juntaow0/Arduino8KeyPiano/README.md

## Arduino Eight Key Piano  
- Constructed an 8-key piano using an Arduino with a partner
- Utilized shift registers for enabling 8 buttons and 8 LEDs with only 6 pins
