juntaow0/Arduino8KeyPiano/acat.h

int Sa [] = {
		NOTE_C4,NOTE_C4,NOTE_C4,NOTE_C4,NOTE_DS4,NOTE_DS4,NOTE_DS4,NOTE_DS4,
		NOTE_F4,NOTE_F4,NOTE_F4,NOTE_DS4,NOTE_DS4,NOTE_DS4,NOTE_F4,NOTE_F4,
		NOTE_F4,NOTE_F4,NOTE_F4,NOTE_F4,NOTE_AS4,NOTE_AS4,NOTE_GS4,NOTE_GS4,
		NOTE_G4,NOTE_F4,NOTE_F4,NOTE_G4,NOTE_G4,NOTE_G4,0,0,NOTE_G4,NOTE_G4,
		NOTE_G4,NOTE_G4,NOTE_AS4,NOTE_AS4,NOTE_AS4,NOTE_AS4,NOTE_C5,NOTE_C5,
		NOTE_C5,NOTE_F4,NOTE_F4,NOTE_F4,NOTE_DS4,NOTE_DS4,NOTE_AS4,NOTE_AS4,
		NOTE_AS4,NOTE_AS4,NOTE_G4,NOTE_G4,NOTE_AS4,NOTE_AS4,NOTE_AS4,NOTE_AS4,
		NOTE_AS4,NOTE_C5,NOTE_C5,NOTE_F4,NOTE_G4,NOTE_AS4,
		NOTE_C4,NOTE_C4,NOTE_C4,NOTE_C4,NOTE_DS4,NOTE_DS4,NOTE_DS4,NOTE_DS4,
		NOTE_F4,NOTE_F4,NOTE_F4,NOTE_DS4,NOTE_DS4,NOTE_DS4,NOTE_F4,NOTE_F4,
		NOTE_F4,NOTE_F4,NOTE_F4,NOTE_F4,NOTE_AS4,NOTE_AS4,NOTE_GS4,NOTE_GS4,
		NOTE_G4,NOTE_F4,NOTE_F4,NOTE_G4,NOTE_G4,NOTE_G4,0,0,NOTE_G4,NOTE_G4,
		NOTE_G4,NOTE_G4,NOTE_AS4,NOTE_AS4,NOTE_AS4,NOTE_AS4,NOTE_C5,NOTE_C5,
		NOTE_C5,NOTE_F4,NOTE_F4,NOTE_F4,NOTE_DS4,NOTE_DS4,NOTE_AS4,NOTE_AS4,
		NOTE_AS4,NOTE_AS4,NOTE_G4,NOTE_G4,NOTE_AS4,NOTE_AS4,NOTE_AS4,NOTE_AS4,
		NOTE_AS4,NOTE_C5,NOTE_C5,0,0,0,
		NOTE_C4,NOTE_C4,NOTE_C4,NOTE_C4,NOTE_DS4,NOTE_DS4,NOTE_DS4,NOTE_DS4,
		NOTE_F4,NOTE_F4,NOTE_F4,NOTE_DS4,NOTE_DS4,NOTE_DS4,NOTE_F4,NOTE_F4,
		NOTE_F4,NOTE_F4,NOTE_F4,NOTE_F4,NOTE_AS4,NOTE_AS4,NOTE_GS4,NOTE_GS4,
		NOTE_G4,NOTE_F4,NOTE_F4,NOTE_G4,NOTE_G4,NOTE_G4,0,0,NOTE_G4,NOTE_G4,
		NOTE_G4,NOTE_G4,NOTE_AS4,NOTE_AS4,NOTE_AS4,NOTE_AS4,NOTE_C5,NOTE_C5,
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
		NOTE_B1,NOTE_B1,NOTE_B1,NOTE_B1,NOTE_E2,NOTE_E2,NOTE_E2,NOTE_E2,
		NOTE_B1,NOTE_B1,NOTE_B1,NOTE_B1,NOTE_E2,NOTE_E2,NOTE_E2,NOTE_E2,
		NOTE_B1,NOTE_B1,NOTE_B1,NOTE_B1,NOTE_E2,NOTE_E2,NOTE_E2,NOTE_E2,
		NOTE_B1,NOTE_B1,NOTE_B1,NOTE_B1,NOTE_E2,NOTE_E2,NOTE_E2,NOTE_E2,
		NOTE_E2,NOTE_E2,NOTE_E2,NOTE_E2,NOTE_E2,NOTE_E2,NOTE_E2,NOTE_E2,
		NOTE_E2,NOTE_E2,NOTE_E2,NOTE_E2,0,0,0,0};
int8_t Pc [] = {
		10,-10,10,-10,10,-10,10,-10,
		10,-10,10,-10,10,-10,10,-10,
		10,-10,10,-10,10,-10,10,-10,
		10,-10,10,-10,10,-10,10,-10,
		10,-10,10,-10,10,-10,10,-10,
		10,-10,10,-10,10,-10,10,-10,
		10,-10,10,-10,10,-10,10,-10,
		10,-10,-10,-10,-10,-10,-10,-10,
		10,-10,10,-10,10,-10,10,-10,
		10,-10,10,-10,10,-10,10,-10,
		10,-10,10,-10,10,-10,10,-10,
		10,-10,10,-10,10,-10,10,-10,
		10,-10,10,-10,10,-10,10,-10,
		10,-10,10,-10,10,-10,10,-10,
		10,-10,10,-10,10,-10,10,-10,
		10,-10,0,0,10,-10,10,-10,
		10,10,10,-10,10,10,-10,-10,10,10,10,-10,10,10,-10,-10,
		10,10,10,-10,10,10,-10,-10,10,10,10,-10,10,10,-10,-10,
		10,10,10,-10,10,10,-10,-10,10,10,10,-10,10,10,-10,-10,
		10,-10,10,-10,10,-10,10,-10,10,10,-10,-10,0,0,0,0};
int measures = 12;
int timeSig = 4;
int bpm = 120;
int precision = 4;
